PANAGIVTHS/ECE338-Parallel-Computer-Architecture/README.md

# ECE338-Parallel-Computer-Architecture

## The gpgpu CLI

`./gpgpu <category> <task>` builds, tests and operates everything below; the categories are
`vivado`, `vitis`, `fpga`, `rtl` and `software`. Run `./gpgpu <category> --help` to list the
tasks. See [tools/gpgpu/README.md](tools/gpgpu/README.md) for its structure, tab completion
and how to add a command.

## SMX RTL simulation (Verilator)

The CLI SMX flow requires Verilator, GNU make, and a C++ compiler. Configure
`tools.verilator.command`, `tools.make.command`, and `tools.native_cxx.command`
in `config/local.yaml` for machine-specific installations. Icarus/vvp are not
used. Python dependencies are initialized by `./gpgpu` (using uv when available).

```bash
./gpgpu rtl smx:build
./gpgpu rtl smx:run
./gpgpu rtl smx:all
./gpgpu --set tests.rtl.random.iterations=3 --set tests.rtl.random.seed=12345 rtl random
./gpgpu --set tests.rtl.trace.enabled=true rtl smx:all
./gpgpu rtl smx:wave
```

`architecture.num_cores` controls both expected-memory generation and the compiled
bench parameter.

### Test cases and the GPGPU model

A case is `tests/hardware/rtl/cases/test<N>/program.asm`, with optional
`dmem_seed.mem` (initial DMEM: hex words, `@<word index>` moves on) and
`ddr_seed.mem` (initial DDR: `<byte address> <word>` hex pairs).
`rtl:generate` assembles each case to `program.mem` and runs that machine
code on the GPGPU model (`tools/tests/gpgpu_model.py`) to produce the expected
`regfile_c<lane>.mem`, `data.mem` and, for a case that uses DDR, `ddr.mem`
(`bursts <n>` and the expected DDR words). The model follows the hardware's
rules: lockstep lanes that branch with lane 0, the kernel ending at lane 0's
RET, the memory map and permissions of `MemorySubsystemPkg::decode_access`,
ascending-lane order for same-word DMEM stores, and one AXI burst per group per
store instruction. A case must end with RET without a fault; a branch the lanes
disagree on or lanes storing different values to one DDR word in one
instruction is reported. Every constant comes from the RTL packages:
`rtl:constants` elaborates them with pyslang into
`<paths.build.root>/tests/rtl/rtl_constants.txt` (`pkg::NAME=value`). Without
the DDR backend (`architecture.ddr_enable: false`), the benches skip cases that
have a `ddr.mem`. Each suite compiles every `hardware.sources.extensions` file
under `paths.rtl.sources.gpgpu`, minus its own `tests.rtl.<suite>.exclude_sources`
(directory or file names), with `hardware.sources.ordered` first (packages and
interfaces before their users; excluded entries are dropped).
`hardware.sources.header_extensions` files are cache dependencies only. The bench and top module come from
`tests.rtl.<suite>.testbench` and `tests.rtl.<suite>.top`. Every bench attaches the
AXI4 slave model `tests.rtl.axi_slave.source` (compiled before the bench) to the
GPGPU's DDR master; `tests.rtl.axi_slave.parameters` set its latency, READY/VALID
rates and seed. `tests.rtl.<suite>.parameters` override HDL parameters for one
suite. Headers next to a bench (`tb_e2e_host.svh`) are found with `-I` and tracked.

Generated C++, objects, the native `main` binary, `build.log`, and `simulation.log`
stay under `<paths.build.root>/tests/rtl/smx/`. Runtime uses this directory with
a `cases` link to the test inputs, so pipeline timing diagram `trace.csv` files
remain in `tests/hardware/rtl/cases/test*/`. `tests.rtl.trace.enabled` (all suites, off
by default, since it slows builds and runs; set it to true to write waveforms)
adds `tests.rtl.trace.verilator_flags` at compile time and passes
`+DUMP_FILE=<tests.rtl.trace.dump_file>` at runtime; the dump lands in the suite's
build directory, and every run first removes the previous one. The default flags
(`--trace-fst --trace-structs`) split packed structs into named fields and keep
enum state names. `rtl:<suite>:wave` opens the dump of the suite's last traced run
in Surfer (`tools.surfer.command`) and returns at once, so the window does not
block other commands; it does not run the suite. `--plain` keeps console output
without the monitor.
The build cache tracks sources, headers, compiler command/options, make, C++
compiler, and core count. Random testing reuses the same compiled executable,
prints reproducible seeds, logs to `<paths.build.root>/tests/rtl/random/random.log`,
and preserves the first failing `cases/test999` input.

### E2E (AXI4-Lite)

```bash
./gpgpu rtl e2e:all
./gpgpu --set tests.rtl.trace.enabled=true rtl e2e:all
```

The bench file and top module come from `tests.rtl.e2e.testbench` and
`tests.rtl.e2e.top`. The bench instantiates the AXI4-Lite wrapper (the IP top
used on the FPGA) and touches the GPGPU only through AXI4-Lite and the IRQ pin. It first checks the
CSR map and error responses, plus a host-only DMEM write/readback. Then, for
each case, it clears DMEM, loads and verifies IMEM, enables the IRQ, writes
`CONTROL.START`, waits for the completion IRQ, checks `STATUS`/`IRQ_STATUS` and
the W1C acknowledge, and compares all of DMEM with the expected data file and, for a
DDR case, the DDR model's contents and burst count with `ddr.mem`. Register files are
not host-visible, so they are checked only by the SMX suite. Its
`tests.rtl.e2e.exclude_sources` keeps `interfaces/` (the AXI wrapper) that the SMX suite
excludes. Every bench setting (case root, case prefix and first index, program
and data file names, clock period, reset length, timeouts, RET encoding, unmapped
address, INFO version) is a required plusarg taken from `tests.rtl.e2e.plusargs`.
The bench has no defaults and stops if any is missing; add `TEST_END` to stop
early. The aggregate
`rtl:{build,run,all}` tasks cover every suite.

### DDR (AXI4 master)

```bash
./gpgpu rtl ddr:all
```

The DDR bench shares the E2E harness (`tests/hardware/rtl/tb_e2e_host.svh`: the
AXI4-Lite top, the slave model, host tasks and RISC-V encoders) and is built
with `DDR_ENABLE=1` from `tests.rtl.ddr.parameters`. Its kernels only store to
the framebuffers (the DDR read path is not implemented yet): consecutive words,
one group per lane (more groups than write slots), gaps carrying `WSTRB=0`, the
same word from every lane, a store loop, and SLVERR/DECERR injection checked
through `FAULT_INFO`/`FAULT_LANES`/`FAULT_PC`. Results are read through the
model's backdoor, with burst counts and an idle bus checked after each kernel.
Then it runs every directed case, DDR cases included.
`tests.rtl.range` in `config/profiles/default.yaml` selects directed SMX/E2E
case IDs: `"all"` (default) or an inclusive range such as `"1-10"` or `"5-5"`.
For a one-off selection:

```bash
./gpgpu --set tests.rtl.range=1-10 rtl smx:all
```

The range is passed as `+TEST_IDX` / `+TEST_END` at runtime, without recompiling
the bench. Explicit ranges with missing case sources fail before simulation.
Shared input generation still prepares all cases; random testing is unaffected.

## Running programs on FPGA

The repository has a generic flow for compiling a program, loading it on the FPGA through UART, running it in chunks, dumping a program-defined output window, and optionally visualizing the results.  The root entry point is `./run.sh`; the program-specific behavior lives under `programs/<program>/`.

### Quick example

```bash
./run.sh -p nbody --fpga --port /dev/ttyACM0 --steps 50 --runs 10 --visualize
```

This command means:

- build the `nbody` program,
- load its RISC-V instruction memory image into the FPGA,
- run 10 kernel launches,
- ask each launch to advance 50 logical nbody steps,
- after each launch, dump the nbody output window from DMEM,
- let `programs/nbody/fpga.py` append the output to `programs/nbody/data.csv` and update the live visualization,
- after the loop, run the normal visualization script if requested.

Use the serial port that corresponds to your board, for example `/dev/ttyUSB1` or `/dev/ttyACM0`.

### Top-level wrapper: `run.sh`

The root `run.sh` is only a thin wrapper:

```bash
./run.sh ...
```

internally executes:

```bash
programs/run.sh ...
```

This exists so users can start from the repository root while keeping all program build/run logic inside `programs/`.

### Program runner: `programs/run.sh`

`programs/run.sh` performs these steps:

1. Discovers available program directories under `programs/`.
2. Parses command-line options such as:
   - `-p, --program PROGRAM`
   - `--fpga`
   - `--port PORT`
   - `--baud BAUD`
   - `--steps N`
   - `--runs N`
   - `--total-steps N`
   - `--skip-load-imem`
   - `--visualize` / `--no-visualize`
3. Builds the selected program with:

   ```bash
   make -C programs PROG=<program> clean
   make -C programs PROG=<program> <target>
   ```

   For an FPGA run it also ensures the raw instruction memory file exists:

   ```bash
   programs/<program>/<program>_instructions.mem
   ```

4. If `--fpga` was requested, it calls the generic Python FPGA runner:

   ```bash
   python3 programs/fpga_run.py \
       --program <program> \
       --port <port> \
       --baud <baud> \
       --steps-per-run <steps> \
       --runs <runs>
   ```

The shell script does not know the nbody memory layout.  It only builds the program and forwards FPGA-run options to `programs/fpga_run.py`.

### Generic FPGA loop: `programs/fpga_run.py`

`programs/fpga_run.py` owns the common UART lifecycle.  It imports one program-specific adapter from:

```text
programs/<program>/fpga.py
```

The adapter must define:

```python
class ProgramAdapter:
    ...
```

The generic flow is:

1. Import `programs/<program>/fpga.py` and construct `ProgramAdapter(program_dir=...)`.
2. Determine the IMEM file.  By default this is:

   ```text
   programs/<program>/<program>_instructions.mem
   ```

3. Ask the adapter where the output lives in DMEM:

   ```python
   output_offset_words()
   output_word_count()
   ```

4. Call the adapter's optional configuration hook:

   ```python
   configure(steps_per_run=..., runs=..., total_steps=..., visualize=...)
   ```

5. Open the UART monitor using `host/baremetal/gpgpu_uart.py`.
6. Unless `--skip-load-imem` is used, load the program into IMEM.
7. Optionally call:

   ```python
   initial_dmem()
   ```

   if the adapter provides it.
8. For each run/chunk:
   1. Compute:

      ```text
      start_step = run_index * steps_per_run
      steps_this_run = steps_per_run
      ```

      If `--total-steps` was used, the last chunk may be shorter.

   2. Call the adapter before launching the kernel:

      ```python
      before_run(run_index=..., start_step=..., steps=...)
      ```

      The adapter returns DMEM writes as either:

      ```python
      (offset_word, [word0, word1, ...])
      ```

      or a list of such tuples.  The generic runner writes those words to DMEM through UART.

   3. Start the FPGA core:

      ```python
      uart.run()
      ```

   4. Dump the adapter-defined output window:

      ```python
      output = uart.dump_dmem_bin(count=output_words, offset=output_offset)
      ```

   5. Hand the dumped words back to the adapter:

      ```python
      process_output(run_index=..., start_step=..., steps=..., words=output)
      ```

   6. Optionally call:

      ```python
      after_run(run_index=..., start_step=..., steps=..., words=output)
      ```

7. After all chunks finish, call:

   ```python
   finalize(visualize=...)
   ```

8. Print success.

The key idea is that `fpga_run.py` is program-agnostic.  It knows how to talk to the board, but not what a program's arguments or output mean.

### Program-specific adapter: `programs/nbody/fpga.py`

`programs/nbody/fpga.py` defines the nbody host-side ABI.  It must match the DMEM constants used by `programs/nbody/nbody.c`.

Current nbody host-visible words:

```text
DMEM[16] = magic word 0x4e424459 ("NBDY")
DMEM[17] = steps to run in this kernel launch
DMEM[18] = reset flag; 1 for first launch, 0 for later launches
DMEM[19] = logical start step
```

Current nbody output window:

```text
DMEM[1024 .. 1024 + 64)
```

There are 32 bodies.  Each body writes two output words:

```text
DMEM[1024 + body*2 + 0] = x pixel
DMEM[1024 + body*2 + 1] = y pixel
```

The nbody adapter implements the generic hooks as follows:

- `configure(...)`
  - creates or truncates `programs/nbody/data.csv`,
  - writes the CSV header,
  - clears in-memory visualization history.

- `output_offset_words()`
  - returns `1024`.

- `output_word_count()`
  - returns `NUM_BODIES * 2`, currently `64`.

- `before_run(run_index, start_step, steps)`
  - returns a write to `DMEM[16..19]`,
  - sets the reset flag to `1` only for `run_index == 0`,
  - sets reset to `0` for later chunks so the kernel continues from DMEM-resident state.

- `process_output(...)`
  - reads the dumped output words,
  - converts them from 32-bit hex to signed integers,
  - appends one row to `programs/nbody/data.csv`,
  - updates `programs/nbody/fpga_latest.svg` for live preview.

- `finalize(visualize=True)`
  - runs `programs/nbody/visualize.py` after the FPGA loop if visualization was requested.

### Chunked execution model

The intended nbody FPGA usage is chunked execution:

```text
host writes args for steps 0..49
kernel runs 50 steps
host dumps output and visualizes
host writes args for steps 50..99
kernel runs next 50 steps from persistent DMEM state
host dumps output and visualizes
...
```

The kernel must therefore keep persistent simulation state in fixed DMEM windows, not only in registers.  The host only reads the output window and writes the small args block before each launch.

### Restarting nbody from zero

To rebuild the nbody program from scratch while preserving the FPGA flow, keep these contracts stable first:

1. Keep `programs/nbody/fpga.py` and `programs/nbody/nbody.c` in agreement on all DMEM word offsets.
2. Start with the smallest kernel that:
   - reads `DMEM[16..19]`,
   - initializes deterministic per-body state when reset is nonzero,
   - runs `steps` iterations,
   - writes `DMEM[1024..1087]`,
   - returns with the hardware completion convention.
3. Verify one kernel launch first:

   ```bash
   ./run.sh -p nbody --fpga --port /dev/ttyUSB1 --steps 1 --runs 1 --no-visualize
   ```

4. Then verify chunking/resume behavior:

   ```bash
   ./run.sh -p nbody --fpga --port /dev/ttyUSB1 --steps 50 --runs 2 --visualize
   ```

5. Only after the minimal resumable kernel works should the full pairwise-gravity nbody logic be added back.

This staged approach makes it easier to identify whether a failure comes from the host flow, DMEM ABI, kernel completion, stack/register spilling, branch divergence, or the actual nbody physics.
