PANAGIVTHS/ECE338-Parallel-Computer-Architecture/config/profiles/default.yaml

architecture:
  num_cores: 32
  interface_version: 2
  # DDR backend of the memory subsystem (reported in INFO_FEATURES). Without
  # it, framebuffer and texture accesses complete as ST_UNMAPPED. The DDR read
  # path is not implemented yet: a texture load never completes.
  ddr_enable: true

hardware:
  fpga:
    part: xc7z020clg484-1
    agent:
      device: "210299730789"
      directory: /app
    uart:
      port: /dev/ttyUSB0
      baud: 115200
      sudo: true
      python: python3
    upload:
      destination: njason@192.168.1.13
      directory: /home/njason/upload
  serial:
    port: /dev/ttyACM0
    baud: 115200
  # RTL source discovery shared by every consumer (RTL test suites, Vivado IP):
  # all `extensions` files under paths.rtl.sources.gpgpu, minus the consumer's
  # own `exclude_sources` list. An entry is a bare directory/file name matched
  # at any depth (e.g. experimental) or a path relative to paths.rtl.sources.gpgpu
  # (e.g. memory/bram, sp/ALU.sv). `ordered` files come first,
  # in dependency order (a package/interface before any file using its types,
  # including other packages); entries a consumer excludes are dropped.
  # `header_extensions` files are include headers, never compiled on their own.
  sources:
    extensions: [.sv, .v]
    header_extensions: [.svh]
    ordered:
      - packages/gpu_pkg.sv
      - packages/riscv_pkg.sv
      - packages/alu_pkg.sv
      - packages/warp_pkg.sv
      - packages/pipeline_pkg.sv
      - memory/MemoryInterface.sv
      - memory/ddr/AXI4FullPkg.sv
      - memory/ddr/AXI4FullInterface.sv
      - memory/ddr/DDRBackendPkg.sv
      - memory/ddr/DDRBackendInterface.sv
      - memory/MemorySubsystemPkg.sv
      - memory/MemorySubsystemInterface.sv
      - control/ControlPkg.sv
  vivado:
    ip_project_name: gpgpu_ip_dev
    project_name: gpgpu_system
    bd_name: design_1
    top: design_1_wrapper
    xsa_name: gpgpu_platform
    version: "2025.2"
    jobs: 6
    # Requested PS fabric clock FCLK_CLK0 (MHz) driving the GPGPU, its AXI
    # interconnect and reset; Vivado selects the nearest achievable frequency.
    # Applied to new and saved block designs on vivado:system:create. The
    # display has its own fixed clock (FCLK_CLK1), so this follows the
    fabric_clock_mhz: 40
    # phys_opt_design after routing in impl_1, with its -directive (e.g.
    # AggressiveExplore, Explore, AlternateFlowWithRetiming, Default). Applied
    # on every implementation run, so disabling it also takes effect.
    post_route_phys_opt:
      enabled: true
      directive: AggressiveExplore
    peripheral:
      base_address: "0x43C00000"
      range: "0x00010000"
    # Production IP: hardware.sources minus `exclude_sources`; headers first,
    # the file declaring the IP top module last (the packager's top file).
    # Keeps interfaces/ (the AXI4-Lite top); drops the deprecated host command
    # processor. `memory_init` (repo-relative) is staged before all HDL; its
    # file name must match the RTL's default $readmemh name.
    exclude_sources: [experimental, HostControllerProcessor.sv]
    memory_init: tools/hardware/vivado/ip/empty.mem
    # Other IP published beside the packaged GPGPU in the IP repository
    # (<paths.build.root>/hardware/vivado/ip_repo): every directory under
    # `root` except those named in `exclude`, copied as is. The block design
    # finds their IP and interface definitions there.
    vendor_ip:
      root: hardware/rtl
      exclude: [gpgpu]
  vitis:
    version: "2025.2"
    platform_name: gpgpu_platform
    host_name: gpgpu_host
    cpu: ps7_cortexa9_0
    domain: standalone_ps7_cortexa9_0
    os: standalone
    template: empty_application
    default_archive: tools/hardware/vitis/default-project.zip
    host_sources:
      - software/host/xc7z020/gpgpu_driver.c
      - software/host/xc7z020/main.c

software:
  host:
    # Generated by software:host:platform from the RTL packages and the
    # settings below, and committed; the Vitis host build stages it with the
    # driver.
    platform_header: software/host/xc7z020/gpgpu_platform.h
    # RTL attribute that exports a package parameter or enum typedef to the
    # header, e.g. (* host *) localparam ... ; the RTL markers must use it.
    export_attribute: host
    # Prefix of every generated #define; the host driver uses these names.
    define_prefix: GPGPU_
    # Wait for completion with the PS interrupt (true) or by polling
    # IRQ_STATUS (false).
    use_irq: true
    # GIC interrupt ID of the GPU interrupt: IRQ_F2P[0] is ID 61 on Zynq-7000.
    irq_id: 61
    # Boot-time autorun: when enabled, the host loads `program` (a directory
    # under software/programs) into IMEM, writes `args` to GPGPU_ARGS, shows
    # framebuffer `display` and runs the kernel back to back until a key
    # arrives on the UART; then the monitor starts. software:host:autorun
    # generates `header` from these and the program's RISC-V build; it is
    # committed, like platform_header, so the Vitis host build needs no
    # RISC-V toolchain.
    autorun:
      header: software/host/xc7z020/gpgpu_autorun.h
      enabled: false
      program: ripple
      # GPGPU_ARGS words in order: 32-bit integers, or names from
      # platform_header such as GPGPU_FB0_BASE. Unlisted words are 0.
      args: [GPGPU_FB0_BASE, GPGPU_FB_WIDTH, GPGPU_FB_HEIGHT, 0]
      display: 0
  riscv:
    march: rv32im
    abi: ilp32

tests:
  rtl:
    # Waveform tracing for every suite: `enabled` adds `verilator_flags` at
    # compile time and passes +DUMP_FILE=<dump_file> (written in the suite's
    # build directory). FST keeps enum names; --trace-structs splits packed
    # structs into named fields.
    trace:
      enabled: false
      verilator_flags:
        - --trace-fst
        - --trace-structs
      dump_file: dumpfile.fst
    # Directed SMX/E2E test IDs, inclusive: "all" or e.g. "1-10".
    range: "all"
    # DDR model every bench attaches to the GPGPU's AXI4 master. `source` is
    # compiled before the bench; `parameters` are the benches' HDL
    # parameters for it (-G): response latency range in cycles after a
    # burst's last handshake, and the chance in percent per cycle that a
    # READY (AW/W/AR) or a due VALID (B/R) is high. SEED is non-zero.
    axi_slave:
      source: tests/hardware/rtl/AXI4SlaveMemory.sv
      parameters:
        AXI_SLAVE_LATENCY_MIN: 1
        AXI_SLAVE_LATENCY_MAX: 40
        AXI_SLAVE_READY_PCT: 75
        AXI_SLAVE_VALID_PCT: 75
        AXI_SLAVE_SEED: 1
    # Per suite: `testbench` is relative to the repository root, `top` is the
    # bench's top module, `exclude_sources` drops directories/files from
    # hardware.sources, `parameters` override HDL parameters (-G) for this
    # suite only, `plusargs` are passed to the simulator as +NAME=value.
    smx:
      testbench: tests/hardware/rtl/tb_GPGPU.sv
      top: tb_GPGPU_smx_only
      # No AXI wrapper: the bench instantiates GPGPU directly.
      exclude_sources: [experimental, interfaces]
      parameters: {}
      plusargs: {}
    e2e:
      testbench: tests/hardware/rtl/tb_GPGPU_e2e.sv
      top: tb_GPGPU_e2e
      # Keeps interfaces/ for the AXI4-Lite top; drops the deprecated host
      # command processor.
      exclude_sources: [experimental, HostControllerProcessor.sv]
      parameters: {}
      # All required by the bench (no defaults in SystemVerilog). +TEST_END
      # is optional and may be added here to stop after a given case.
      plusargs:
        UNMAPPED_ADDR: "00008000"   # hex; must decode to no CSR/IMEM/DMEM
        # Shared AXI4-Lite host and directed-case settings (tb_e2e_host.svh)
        <<: &e2e_host_plusargs
          CLOCK_PERIOD_NS: 10
          RESET_CYCLES: 20
          TEST_TIMEOUT_CYCLES: 10000  # launch to completion IRQ
          AXI_TIMEOUT_CYCLES: 1000    # per AXI channel handshake
          RET_INSTR: "00008067"       # hex; kernel end, IMEM is loaded up to it
          TEST_ROOT: cases            # relative to the suite's run directory
          CASE_PREFIX: test           # case directories are <prefix><index>
          TEST_IDX: 1                 # first case index
          PROGRAM_FILE: program.mem
          DATA_FILE: data.mem
          DDR_SEED_FILE: ddr_seed.mem # optional per case: loaded into the DDR model
          DDR_FILE: ddr.mem           # per DDR case: expected DDR words and bursts
    ddr:
      testbench: tests/hardware/rtl/tb_GPGPU_ddr.sv
      top: tb_GPGPU_ddr
      exclude_sources: [experimental, HostControllerProcessor.sv]
      # Store kernels against the DDR model, whatever architecture.ddr_enable is.
      parameters:
        DDR_ENABLE: 1
      plusargs:
        <<: *e2e_host_plusargs
    random:
      iterations: 100
      # Set a non-zero integer for reproducibility; 0 chooses and prints a seed.
      seed: 0

paths:
  rtl:
    sources:
      gpgpu: hardware/rtl/gpgpu
  build:
    root: build

# Commands are names or paths. Machine-specific paths belong in config/local.yaml.
tools:
  git:
    command: git
    required: true
  python:
    command: python3
    required: true
  make:
    command: make
    required: true
  native_cc:
    command: gcc
    required: true
  riscv_gcc:
    command: riscv64-unknown-elf-gcc
    required: true
  verilator:
    command: verilator
    required: true
  native_cxx:
    command: g++
    required: true
  vivado:
    command: vivado
    required: false
  vitis:
    command: vitis
    required: false
  ssh:
    command: ssh
    required: false
  scp:
    command: scp
    required: false
  gtkwave:
    command: gtkwave
    required: false
