PANAGIVTHS/ECE338-Parallel-Computer-Architecture/hardware/rtl/gpgpu/sp/HazardUnit.sv

module HazardUnit
    import gpu_pkg::*;
    import riscv_pkg::*;
    import pipeline_pkg::*;
#(
    parameter int unsigned MUL_LATENCY = 3
)(
    input reg_addr_t i_id_rs1,
    input reg_addr_t i_id_rs2,
    input reg_addr_t i_idex_rd,
    input logic i_ex_is_load,
    input logic i_ex_is_mul,
    input logic i_id_is_mul,
    input mul_hazard_t i_mul [0:MUL_LATENCY-1],
    input instr_type_t i_id_instr_type,
    input logic i_branch_taken,
    output logic o_data_hazard,
    output logic o_flush,
    // Which rule raised o_data_hazard (o_flush is the taken branch)
    output logic o_load_use,
    output logic o_mul_hazard
);

    logic mul_pending, mul_dependency;

    always_comb begin
        mul_pending = 1'b0;
        mul_dependency = 1'b0;
        for (int stage = 0; stage < MUL_LATENCY; stage++) begin
            mul_pending |= i_mul[stage].valid;
            mul_dependency |= i_mul[stage].valid &&
                ((i_id_rs1 == i_mul[stage].rd) || (i_id_rs2 == i_mul[stage].rd));
        end
    end

    always_comb begin
        o_data_hazard = 1'b0;
        o_flush = 1'b0;
        o_load_use = 1'b0;
        o_mul_hazard = 1'b0;

        //! Standard ALU RAW Hazard
        if (i_ex_is_load && (i_idex_rd != '0)) begin
            if ((i_id_rs1 == i_idex_rd) ||
                ((i_id_instr_type != INSTR_TYPE_I) && (i_id_rs2 == i_idex_rd))) begin
                o_data_hazard = 1'b1;
                o_load_use = 1'b1;
            end
        end else if (i_branch_taken) begin
            o_data_hazard = 1'b1;
            o_flush = 1'b1;
            //! When there is a mul in EX stall, EXCEPT when the id stage is
            //! a multiplication that has no dependency on the muls that are
            //! inside EX.
        end else if ((i_ex_is_mul || mul_pending) && !(
            i_id_is_mul &&
            
            //! 1. Check dependency against the MUL currently in the EX stage
            (i_id_rs1 != i_idex_rd) && (i_id_rs2 != i_idex_rd) &&

            //! 2. Check dependency against every registered MUL stage
            !mul_dependency
        )) begin
            o_data_hazard = 1'b1;
            o_mul_hazard = 1'b1;
        end
    end
endmodule
