PANAGIVTHS/ECE338-Parallel-Computer-Architecture/hardware/rtl/gpgpu/sp/ALU.sv

`include "constants.svh"

module ALU (
    input clk,
    input rst,
    input [31:0] i_operand_a,
    input [31:0] i_operand_b,
    input [3:0] i_alu_op,
    input i_mul_valid,
    input i_global_stall,
    output reg [31:0] o_alu_out,
    output reg o_alu_zero
);
    (* use_dsp = "yes" *) reg [31:0] mul_stage1;
    (* use_dsp = "yes" *) reg [31:0] mul_stage2;
    (* use_dsp = "yes" *) reg [31:0] mul_stage3;

    always @(posedge clk) begin
        if (!rst) begin
            mul_stage1 <= 0;
            mul_stage2 <= 0;
            mul_stage3 <= 0;
        end else if (!i_global_stall) begin
            mul_stage1 <= i_operand_a * i_operand_b;
            mul_stage2 <= mul_stage1;
            mul_stage3 <= mul_stage2;
        end
    end
    
    always @(*) begin
        if (i_mul_valid) begin
            o_alu_out = mul_stage3;
        end else begin 
            case (i_alu_op)
                `ALU_ADD: o_alu_out = i_operand_a + i_operand_b;
                `ALU_SUB: o_alu_out = i_operand_a - i_operand_b;
                `ALU_AND: o_alu_out = i_operand_a & i_operand_b;
                `ALU_OR:  o_alu_out = i_operand_a | i_operand_b;
                `ALU_XOR: o_alu_out = i_operand_a ^ i_operand_b;
                `ALU_SLL: o_alu_out = i_operand_a << i_operand_b[4:0];
                `ALU_SRA: o_alu_out = $signed(i_operand_a) >>> i_operand_b[4:0];
                `ALU_SRL:  o_alu_out = i_operand_a >> i_operand_b[4:0];
                `ALU_SLT:  o_alu_out = ($signed(i_operand_a) < $signed(i_operand_b)) ? 32'b1 : 32'b0;
                `ALU_SLTU: o_alu_out = (i_operand_a < i_operand_b) ? 32'b1 : 32'b0;
                `ALU_LUI: o_alu_out = i_operand_b;
                default: o_alu_out = 32'b0;
            endcase
        end
        o_alu_zero = o_alu_out == 0;
    end
endmodule
