PANAGIVTHS/ECE338-Parallel-Computer-Architecture/(commit log)

2026-04-03 Refactor and fix syntax errors Add TODOs
    [ALU.v, Decoder.v, StreamingProcessor.v]
2026-04-03 Refactor Fix multiple driver definition inside Regfile Add GUCounter Add instr type extraction to Decoder
    [Decoder.v, GPGPU_top.v, StreamingProcessor.v]
2026-04-03 Add 3 stage pipeline
2026-04-03 Fix multiple driver definition inside Memory module
2026-04-03 Add reg to Decoder.v and Refile.v, not reset to GUCounter.v, remove semicolons from header file
    [Decoder.v, StreamingProcessor.v]
2026-04-03 Add testbench for StreamingProcessor, assembler.py that uses a python library to create program hex
2026-04-04 Add don't touch attributes to PC, ALUout, and instruction signals, XOR them and output them to leds, add constraints
2026-04-04 Add signals to instruction memory's write addr and data so vivado doesn't optimize it
    [StreamingProcessor.v]
2026-04-04 Change assembler.py to create instructions' permutations
2026-04-04 Add test suite: each testN/ directory is a test case, assembler.py looks for testN/program.asm and converts it to hex, verilog tb checks against the predefined regfile and data memory
2026-04-04 Replace 0x in the start of every assembled instruction in assembler.py
    [assembler.py]
2026-04-04 Change makefile to call assembler, add test 2
2026-04-05 Add Hazard unit Fix WAW RAW (Not validated)
    [ALU.v, StreamingProcessor.v]
2026-04-05 Declare undeclared wires, add instruction fetch stage before decode, instantiate and connect instruction memory and data memory, add forgotten semicolo
2026-04-12 Rename wires from fd (fetch decode) to id (instruction decode)
2026-04-12 Add instruction memory to instruction fetch stage, change name of program_counter_inst to camel case programCounter
2026-04-12 Change old three stage pipeline to five stages - Move regfile to ID stage - Break MEM and WB into two separate stages instead of one - Move all necessary signals from one stage to the next - Change t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
2026-05-01 Initialize GUCounter (PC) to zero, pass the instruction to the decoder only when rst is enabled, change test case 2
2026-05-01 Fix IF/ID/EX wiring Move Regfile to (half ID half EX) Use parameter for input addresses in memory module
    [StreamingProcessor.v]
2026-05-02 Propagate program counter to all stages (for visualization), add visualizer, move test 2 to 3 and add new test 2
2026-05-02 Fix some issues with core, Add forwarding
    [Decoder.v, ForwardingUnit.v, StreamingProcessor.v, assembler.py]
2026-05-03 Fix core (sub add add)
    [ForwardingUnit.v, StreamingProcessor.v, assembler.py]
2026-05-04 Add clearing program.mem and trace.csv in Makefile
2026-05-04 Add true dual port memory module, single port memory module, and make instruction memory signals and wires (PCs, instr_idx) relative to the memory's length (IMEM_ENTRIES)
2026-05-04 Fix instruction fetching to stall on data_hazard Fix python assembler decoding sw wrong Change assembler to allow comments in program asm Change test 1
    [StreamingProcessor.v, assembler.py]
2026-05-04 Fix memory modules Fix memory instantiation syntax
    [MemoryDualPort.v, MemorySinglePort.v, StreamingProcessor.v, assembler.py]
2026-05-06 Fix wrong wire before i forget AGAIN AND WASTE 2 HOURS
    [StreamingProcessor.v]
2026-05-06 Fix wrong wire name for idex_rd
    [StreamingProcessor.v]
2026-05-11 Add nbody.c and simple.c, add script that compiles the programs to riscv assembly and converts them to .mem to send to GPU as instructions
2026-05-12 Add support for generate block instantiation of the cores Fix core global pipeline stalling, now ALU and regfile also stall.
    [ALU.v, MemoryCrossbarNx2.v, StreamingMultiprocessor.v, StreamingProcessor.v]
2026-05-12 Add register x31 as the thread index in adjacent differences
2026-05-13 Change simple program to test that threadIdx_x works
2026-05-13 Remove stack pointer by filtering the instructions, remove frame pointer from the compiler option
2026-05-15 Add exit instuction to core and testsuite scripts Fix testbench dumbvars race condition
    [StreamingMultiprocessor.v, StreamingProcessor.v, assembler.py, expected_generator.py, random_tester.py]
2026-05-16 Fix GPU bugs Rewrite assembler to get rid off trash lib Fix golden generator script Make random script less random and 100% more evil Fix visualizer on fail
    [Decoder.v, MemoryCrossbarNx2.v, StreamingMultiprocessor.v, StreamingProcessor.v, assembler.py, expected_generator.py, random_tester.py]
2026-05-19 Add end-to-end testbench and tidy up test folder. Add option to read and write both IMEM and DMEM. Make decode stage start one cycle after the core has been enabled and change initial PC to 0
2026-05-19 Fix random test because it was based on the stdout of the testbench
    [random_tester.py, tb_GPGPU.v, tb_GPGPU_e2e.v]
2026-05-19 Fix constraints Need to add register reading functionality and fix tests 10 and 11
    [constraints.xdc, tb_GPGPU_e2e.v]
2026-05-19 Fix top level and constraints for synthesis
    [GPGPU.v, constraints.xdc]
2026-05-19 Add host code for baremetal and fix clock divider
    [GPGPU.v, constraints.xdc, host.py, main.c]
2026-05-19 Added script to automatically run on the board using the hosts UART
2026-05-20 Change Makefile to not skip instructions containing x2, add ./compile.sh helper script, change the expected generator to handle correctly hex immediates
    [expected_generator.py]
2026-05-26 Fixed python scripts consuming more bytes from UART than needed
    [host_uart_helper.py, host_uart_tester.py]
2026-05-27 Update scripts to use the single library for communicating with the GPGPU through UART
2026-05-28 Change nbody so one black hole is in the center and the other bodies orbit it
2026-05-29 Add flow for running the programs from the programs/ dir on the FPGA - Add a run.sh on the root that calls the programs/run.sh - Add an fpga_run.py file that has the abstract logic of: 1. load kernel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
2026-05-30 Add requirements to nbody python scripts and remove assembly and binary files
2026-05-30 Update branching logic to use ALU and not create extra hardware, remove NOPs from tests. Need to fix jalr
    [Decoder.v, StreamingMultiprocessor.v, StreamingProcessor.v]
2026-05-30 Fix wrong program counter forwarded to ID after taken branch
    [StreamingMultiprocessor.v]
2026-05-30 Add follow visualization in nbody, add per frame print for x86
2026-05-30 Change mark debug on a wire
2026-05-31 Add 2D interactive script, 3D implementation version of nbody and 2 datasets for initial positions and velocities
2026-06-01 Add support for output arrays via arguments: - Remove output memory space from linker script - Refactor run.sh - Change and refactor run_fpga.py and fpga.py to pass start of arrays address as argumen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
2026-06-01 Add symmetrical force on bodies and make trails fade after some frames
2026-06-01 Add fpga.py for mandelbrot, make it use array address from arguments - doesn't zoom to infinity yet
    [mandelbrot.h]
2026-07-22 Add basic testbench for experimental FIFO implementation Fix include for FIFO module
    [fifo.v, tb_fifo.v]
2026-07-22 Add experimental Warp Scheduler
    [WarpScheduler.v]
2026-07-22 Fix WarpScheduler priority bug Remove WarpScheduler redundant logic by refactoring logic a little Add testbench for WarpScheduler [Behavioral PASS]
    [WarpScheduler.v, tb_warpscheduler.v]
2026-07-22 Move WARP_READY_STATE into constants
    [WarpScheduler.v, tb_warpscheduler.v]
2026-09-25 Fix top level module, clock generation and VSYNC cycles on HDMI
    [hdmi_controller.v]
2026-09-25 Fix bug on rendered and controller
    [hdmi_controller.v]
2026-09-25 Invert reset because button is active low
    [hdmi_controller.v]
2026-10-31 Refactor CSRBank and GPGPU to expose the interface version. Driver now gets a generated gpgpu_platform header that contains all the infromation the driver needs for the hardware software:host:platfor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
2026-10-31 Add fault detection on SMX, and 3 new CSRs related to fault detection. Driver can now detect such faults and can also reset the GPU in case of a fatal fault
2026-10-31 Update driver to describe CSRs in more detail
2026-10-31 Add test memfault program and make driver messages more clear
2026-11-01 Fix wires not belonging on a per-requester interface.
2026-11-01 Update write assembler to not reverse the mask going into the arbiter
2026-11-02 Update block design to give priority to frame buffer reading
2026-11-04 Fix HDMI blanking issue by removing the serial clock from the first clock divider and using the MMCM inside the rgb2dvi module to keep the clock closer to it and isolate it from the rest of the desig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
2026-11-04 cherry-pick commit 2affd6a from feature/halt-instruction
    All changes are from commit 2affd6a except the following changes:
    - Resolve conflicts after removal of core_complete and refactor of mul
    and pipeline signals
    - Add a combinational logic for mul_busy signal that checks each stage,
    needed after the removal of o_feedback.mul{1,2,3} signals.
    - Change gpgpu_model.py run function to stop when ecall and reg 17 is 0
    and add decode of ecall.
    - Move tests 26-29 from 2affd6a into tests 33-36.
2026-11-05 Update block design: - JITTER_SEL {Max_I_Jitter} on clk_wiz_0 - C_VTG_MASTER_SLAVE {0} (slave mode) - vtg_ce now drives v_tc_0/gen_clken
    Update main.c:
    - New function display_stop() that stops VDMA from reading before resetting it to avoid next VDMA reads starting offsetted
2026-11-05 Add AUIPC and sub-word loads and stores
    Implement AUIPC, LB, LH, LBU, LHU, SB and SH. Add byte write enables to
    the DMEM BRAM and check alignment per access size. Extend the assembler,
    model and fuzzer, and add directed cases test33-36.
2026-11-05 Replace the gpgpu CLI with a layered architecture
    Replace tools/gpgpu_cli, tools/gpgpu_tasks, tools/hardware and
    tools/software with tools/gpgpu, split into cli, app, api, plugins and
    adapters. Only the adapters know about tools, and a test enforces the
    layer boundaries.
    - Change `gpgpu run <task>` to `gpgpu {vivado|vitis|fpga|rtl|software}
    <task>` and add tab completion
    - Add vivado system:synthesis, system:implementation and
    system:bitstream commands
    - Stop Vitis and fpga commands from starting Vivado or Vitis builds:
    missing results stop the command, stale ones warn
    - Allow one command at a time per category of a build tree
    - Rerun only the affected stages after GUI edits to the bl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
2026-11-10 Print the timing of the implementation
2026-11-10 Enhance driver and main host program to display a more detailed performance report
2026-11-11 Add ld_ddr performance counter to differentiate stalls for DDR reading and BRAM accesses
2026-11-12 Drop the unused hardware.serial settings
    Nothing read hardware.serial.port or .baud: the board's UART is
    hardware.fpga.uart, reached over SSH, and the local scripts take
    --port and --baud. The local.yaml example now overrides
    hardware.fpga.uart.port instead.
2026-11-12 Check the installed Vitis against hardware.vitis.version
    hardware.vitis.version only went into the fingerprint of
    vitis:project; nothing checked the Vitis it ran. Every task that runs
    Vitis now checks `vitis --version`, as the Vivado stages check Vivado:
    in its freshness check, so a wrong version is never up to date, and in
    its action, which stops before Vitis starts. The check moves from the
    Vivado flow to tools.py, unchanged, so both flows share it.
2026-11-12 Make the program optimization level an option
    gcc.py compiled every program with a hard-coded -O2.
    software.programs.optimization sets it for the RISC-V kernel and the
    native x86 build alike, so both builds of a program match; only -O0,
    -O1, -O2, -O3, -Os and -Og are accepted.
    Both builds now fingerprint their whole command instead of the core
    count alone, so changing the optimization, software.riscv.march/abi or
    the compiler rebuilds them.
2026-11-12 Replace GTKWave with Surfer and open waveforms from the CLI
    tools.gtkwave was only checked by doctor; no task used it.
    tools.surfer now backs rtl:<suite>:wave, which opens the suite's
    last traced dump in Surfer and returns at once, so the window holds
    neither the command nor the rtl lock. It does not run the suite.
    Every rtl:<suite>:run first removes the previous dump, so a dump that
    exists is always the last run's, and wave reports a missing one
    instead of opening an older trace.
2026-11-13 Replace halt logic with a simpler since halting happens on a warp only when all threads have reconverged
2026-11-13 Make SM stop issuing instructions after exit passes EX stage on one SP
